anhldptit2610/blackpkb/images/blackpkb.jpeg

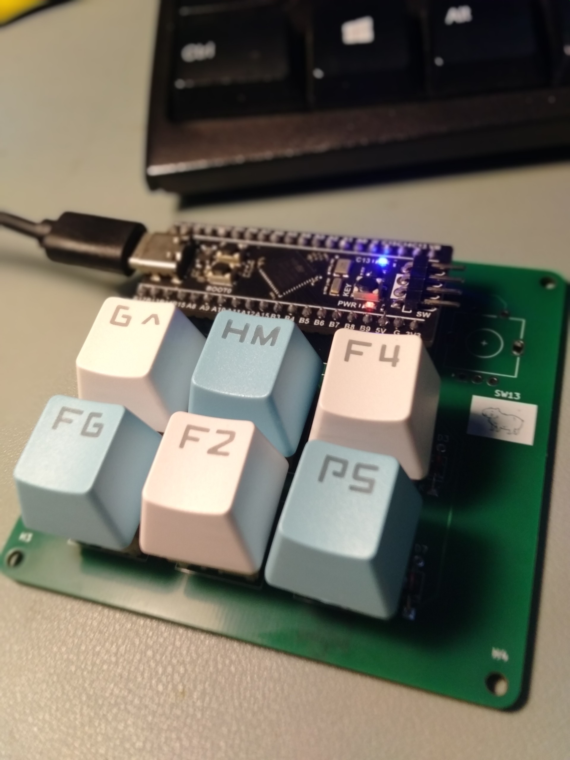
images/blackpkb.jpeg
