anhldptit2610/blackpkb/hardware/blackpkb/blackpkb.kicad_pcb

## KiCad design hardware/blackpkb/blackpkb.kicad_pcb (2024-07-11)

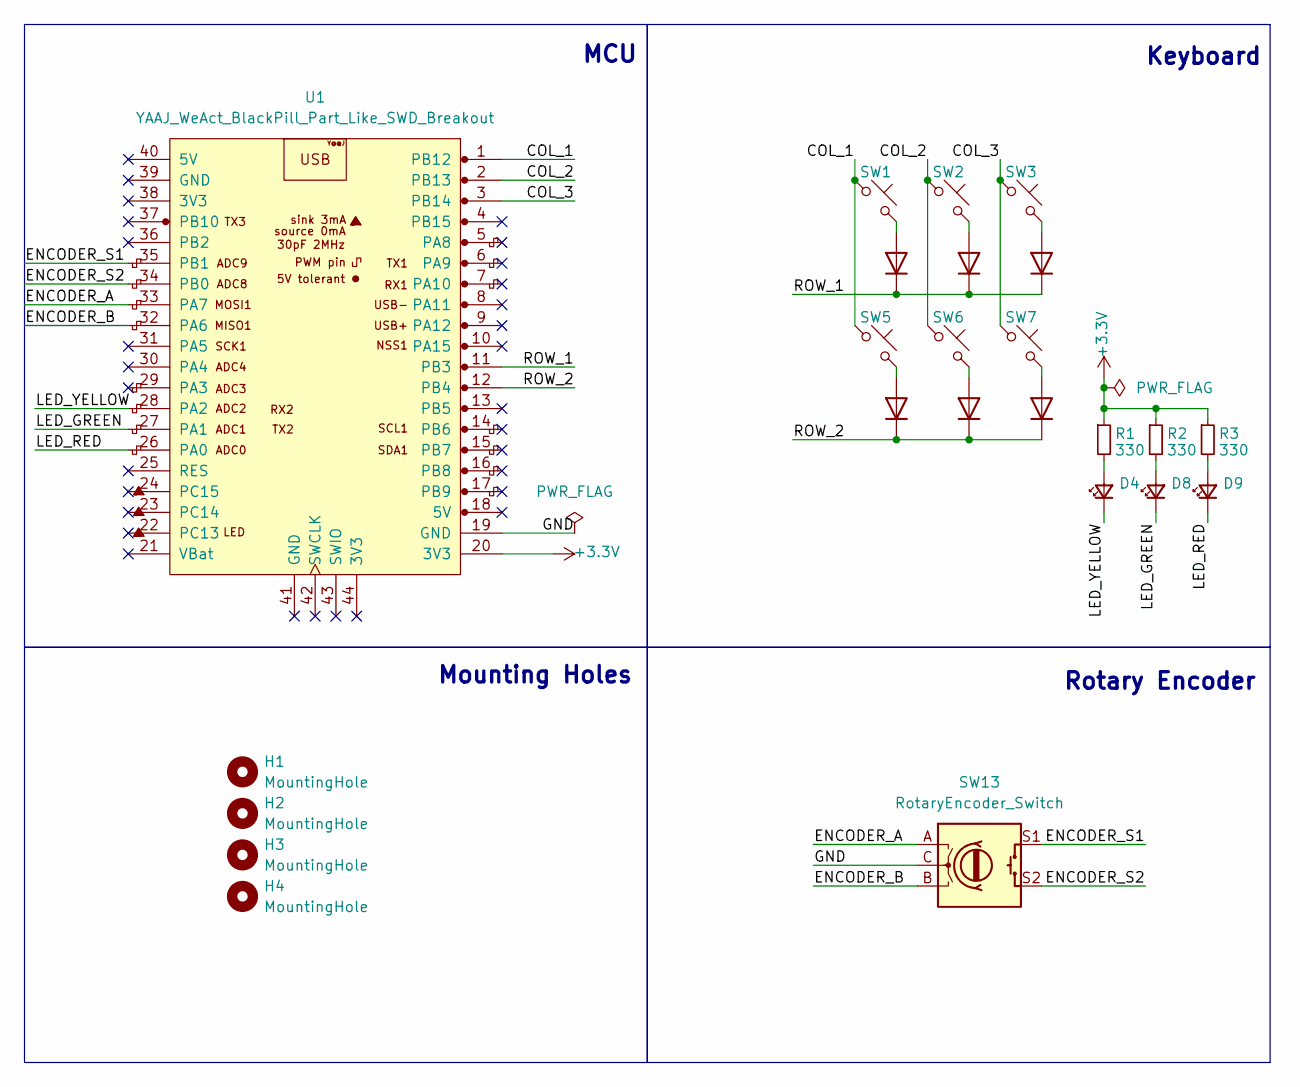
[picture p3: schematic blackpkb.kicad_sch]

Parts:
D1, D2, D3, D5, D6, D7: 1N4148; D_DO-35_SOD27_P7.62mm_Horizontal
D4, D8, D9: LED_Small; LED_D3.0mm
H1, H2, H3, H4: MountingHole; MountingHole_2.7mm_M2.5
R1, R2, R3: 330; R_Axial_DIN0207_L6.3mm_D2.5mm_P7.62mm_Horizontal
SW1, SW2, SW3, SW5, SW6, SW7: SW_Push_45deg; SW_Cherry_MX_1.00u_PCB
SW13: RotaryEncoder_Switch; RotaryEncoder_Alps_EC11E-Switch_Vertical_H20mm
U1: YAAJ_WeAct_BlackPill_Part_Like_SWD_Breakout; YAAJ_WeAct_BlackPill_SWD_2

Connections:
+3.3V: R1.1, R2.1, R3.1, U1.20 (3V3)
/COL_1: SW1.1, SW5.1, U1.1 (PB12)
/COL_2: SW2.1, SW6.1, U1.2 (PB13)
/COL_3: SW3.1, SW7.1, U1.3 (PB14)
/ENCODER_A: SW13.A, U1.33 (PA7)
/ENCODER_B: SW13.B, U1.32 (PA6)
/ENCODER_S1: SW13.S1, U1.35 (PB1)
/ENCODER_S2: SW13.S2, U1.34 (PB0)
/GND: SW13.C, U1.19 (GND)
/LED_GREEN: D8.1 (K), U1.27 (PA1)
/LED_RED: D9.1 (K), U1.26 (PA0)
/LED_YELLOW: D4.1 (K), U1.28 (PA2)
/ROW_1: D1.1 (K), D2.1 (K), D3.1 (K), U1.11 (PB3)
/ROW_2: D5.1 (K), D6.1 (K), D7.1 (K), U1.12 (PB4)
unnamed: D1.2 (A), SW1.2
unnamed: D2.2 (A), SW2.2
unnamed: D3.2 (A), SW3.2
unnamed: D4.2 (A), R1.2
unnamed: D5.2 (A), SW5.2
unnamed: D6.2 (A), SW6.2
unnamed: D7.2 (A), SW7.2
unnamed: D8.2 (A), R2.2
unnamed: D9.2 (A), R3.2

Notes on the sheet:
Keyboard
Mounting Holes
MCU
Rotary Encoder

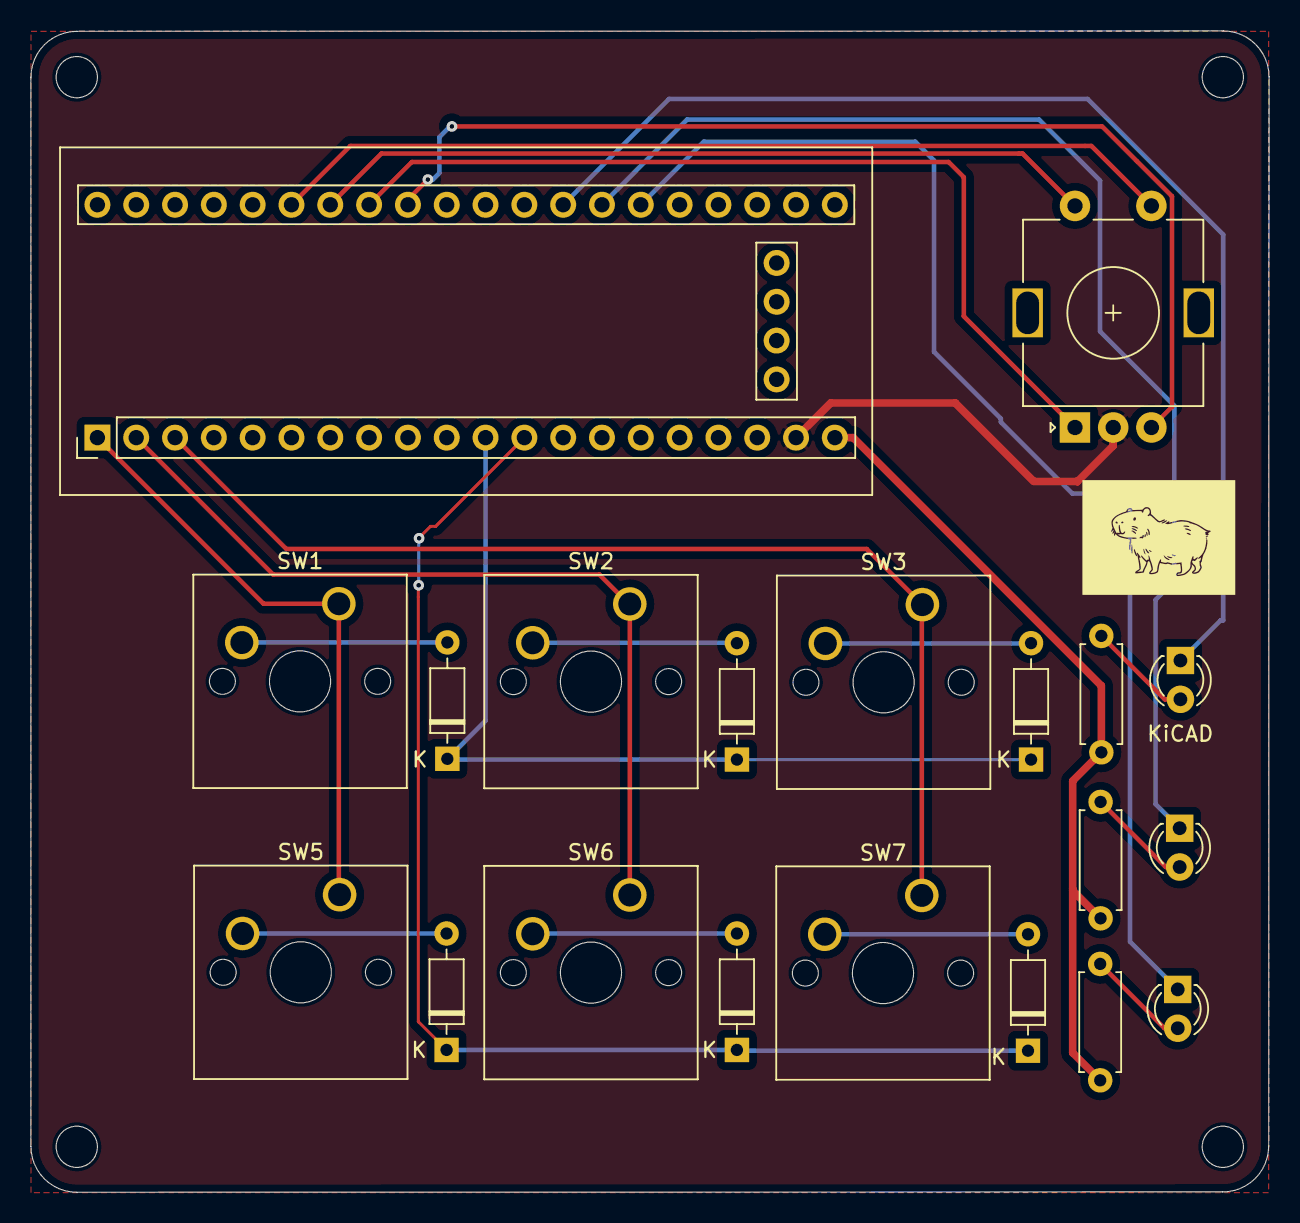
[picture p4: board blackpkb.kicad_pcb from above]

Board: 2 copper layers, 81.0 x 76.0 mm, 24 parts (0 on the bottom side), 23 nets.
