anhldptit2610/blackpkb/firmware/blackpkb/Core/Src/main.c

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
/* Includes ------------------------------------------------------------------*/
#include "main.h"
#include "usb_device.h"

/* USER CODE BEGIN Includes */
#include <stdbool.h>
#include "usbd_hid.h"
#include "keycode.h"
#include "keymatrix.h"
#include "profile.h"
/* USER CODE END Includes */

TIM_HandleTypeDef htim10;
TIM_HandleTypeDef htim11;

/* USER CODE BEGIN PV */
bool matrix[KEYMATRIX_ROW][KEYMATRIX_COL];
int matrixProfile = 0;
volatile bool encoderA, encoderB, cw, ccw, scanned, encoderPressed,
              oldEncoder, newEncoder;
/* USER CODE END PV */

void SystemClock_Config(void);
static void MX_GPIO_Init(void);
static void MX_TIM10_Init(void);
static void MX_TIM11_Init(void);
/* USER CODE BEGIN 0 */
void matrix_reset(void)
{
  for (int i = 0; i < KEYMATRIX_ROW; i++)
    for (int j = 0; j < KEYMATRIX_COL; j++)
      matrix[i][j] = 0;
}

void read_encoder(void)
{
  static int state = 0;

  encoderA = HAL_GPIO_ReadPin(ENCODER_A_GPIO_Port, ENCODER_A_Pin);
  encoderB = HAL_GPIO_ReadPin(ENCODER_B_GPIO_Port, ENCODER_B_Pin);
  switch (state) {
  case 0:
    if (!encoderA)
      state = 1;
    else if (!encoderB)
      state = 4;
    break;
  case 1:
    if (!encoderB)
      state = 2;
    break;
  case 2:
    if (encoderA)
      state = 3;
    break;
  case 3:
    if (encoderA && encoderB) {
      state = 0; 
      cw = 1;
      ccw = 0;
    }
    break;
  case 4:
    if (!encoderA)
      state = 5;
    break;
  case 5:
    if (encoderB)
      state = 6;
    break;
  case 6:
    if (encoderA && encoderB) {
      state = 0;
      cw = 0;
      ccw = 1;
    }
    break;
  default:
    break;
  }
}
/* USER CODE END 0 */

/**
  * @brief  The application entry point.
  * @retval int
  */
int main(void)
{
  /* MCU Configuration--------------------------------------------------------*/

  /* Reset of all peripherals, Initializes the Flash interface and the Systick. */
  HAL_Init();

  /* Configure the system clock */
  SystemClock_Config();

  /* Initialize all configured peripherals */
  MX_GPIO_Init();
  MX_USB_DEVICE_Init();
  MX_TIM10_Init();
  MX_TIM11_Init();
  /* USER CODE BEGIN 2 */
  HAL_TIM_Base_Start_IT(&htim11);
  keymatrix_init();
  matrix_reset();
  cw = ccw = scanned = false;
  encoderPressed = true;
  HAL_GPIO_WritePin(ENCODER_GND_GPIO_Port, ENCODER_GND_Pin, 0);
  HAL_GPIO_WritePin(LED_GPIO_Port, LED_Pin, 1);
  /* USER CODE END 2 */

  /* Infinite loop */
  /* USER CODE BEGIN WHILE */
  while (1)
  {
    /* USER CODE END WHILE */

    /* USER CODE BEGIN 3 */
    read_encoder();
    if (cw) {
      cw = 0;
      encoder_adjust_volume(VOL_UP);
    } else if (ccw) {
      ccw = 0;
      encoder_adjust_volume(VOL_DOWN);
    }

    if (scanned) {
      scanned = false;
      if (encoderPressed) {
        encoderPressed = 0;
        profile_switch();
      }
      for (int i = 0; i < KEYMATRIX_ROW; i++) {
        for (int j = 0; j < KEYMATRIX_COL; j++) {
          if (matrix[i][j]) {
            keymatrix_send_key(i, j);
          }
        }
      }
    }
    HAL_Delay(1);
  }
  /* USER CODE END 3 */
}

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
/* USER CODE BEGIN 4 */
void HAL_TIM_PeriodElapsedCallback(TIM_HandleTypeDef *htim)
{
  // Check which version of the timer triggered this callback and toggle LED
  if (htim == &htim11) {
    scanned = true;
    HAL_GPIO_WritePin(ENCODER_GND_GPIO_Port, ENCODER_GND_Pin, 0);
    newEncoder = HAL_GPIO_ReadPin(ENCODER_SW_GPIO_Port, ENCODER_SW_Pin);
    encoderPressed = !newEncoder && oldEncoder;
    oldEncoder = newEncoder;
    // encoderPressed = HAL_GPIO_ReadPin(ENCODER_SW_GPIO_Port, ENCODER_SW_Pin);
    HAL_GPIO_WritePin(ENCODER_GND_GPIO_Port, ENCODER_GND_Pin, 1);
    keymatrix_scan(matrix);
  }
}
/* USER CODE END 4 */
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
