anhldptit2610/blackpkb/(commit log)

2024-06-07 first commit. Hardware v0.1 is done
    [629105150521 (rev1).stp, blackpkb.kicad_pcb, blackpkb.kicad_sch]
2024-06-07 section the schematic. Add infomations, remove redundant files
    [629105150521 (rev1).stp, blackpkb.kicad_sch]
2024-07-02 hardware v0.2
    [blackpkb.kicad_pcb, blackpkb.kicad_sch]
2024-07-11 the keyboard now works. Can use one key to type number 1 :>
    [blackpkb.kicad_pcb, bom.csv, designators.csv, positions.csv]
2024-07-18 add rotary encoder and mode LEDs. Volume now can be adjusted
